raulhorgos/Dynamic-Thermal-Imaging-Camera/Photos/Test example.jpeg

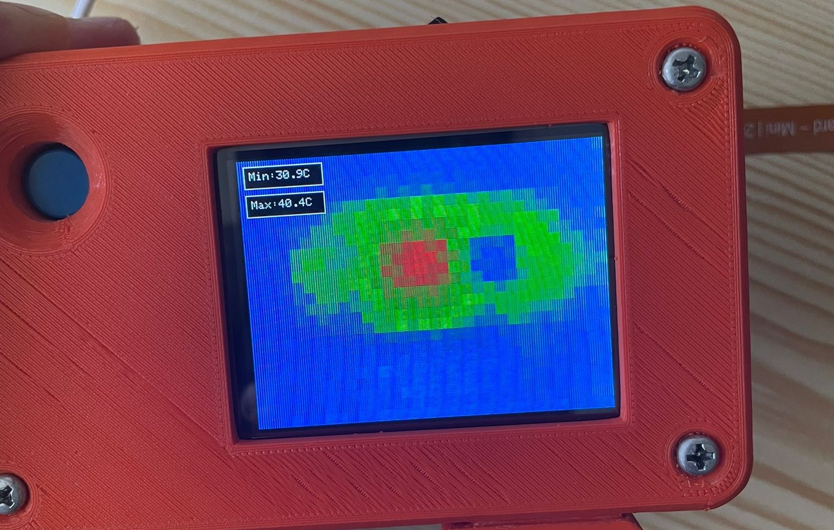
Photos/Test example.jpeg
