raulhorgos/Dynamic-Thermal-Imaging-Camera/3D render of the enclosre.png

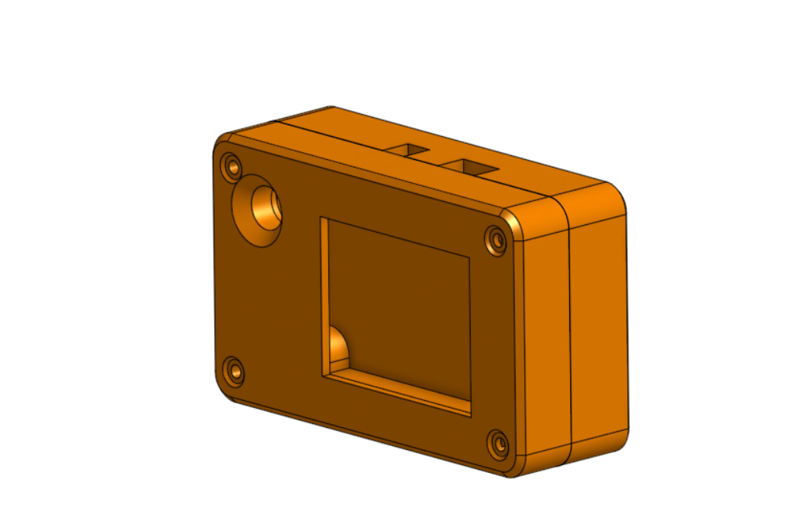
3D render of the enclosre.png
