raulhorgos/Dynamic-Thermal-Imaging-Camera/gantt.png

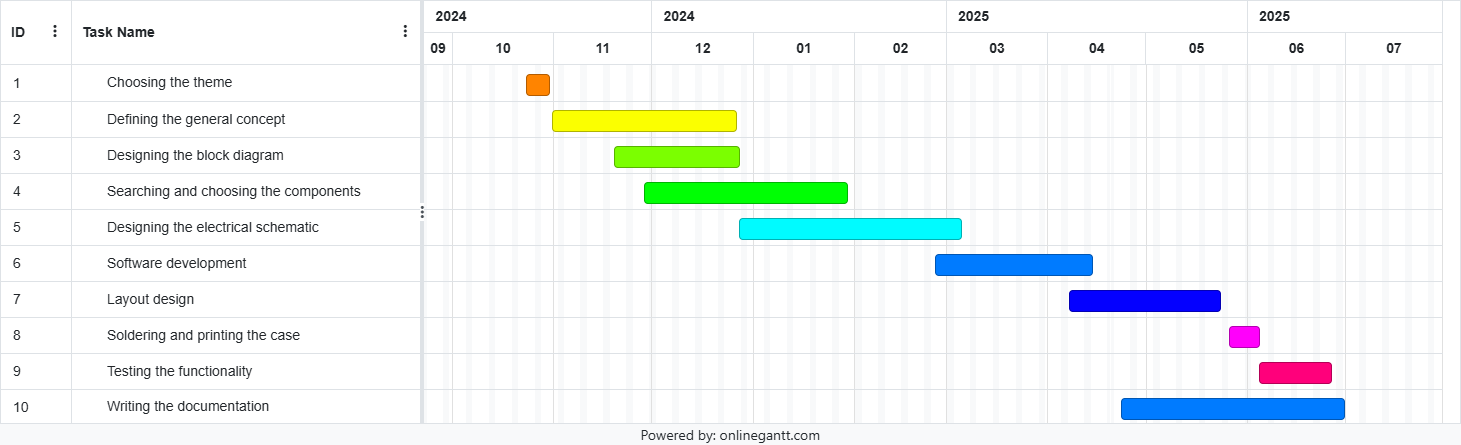
gantt.png
