raulhorgos/Dynamic-Thermal-Imaging-Camera/Photos/3D render of the eclosure.png

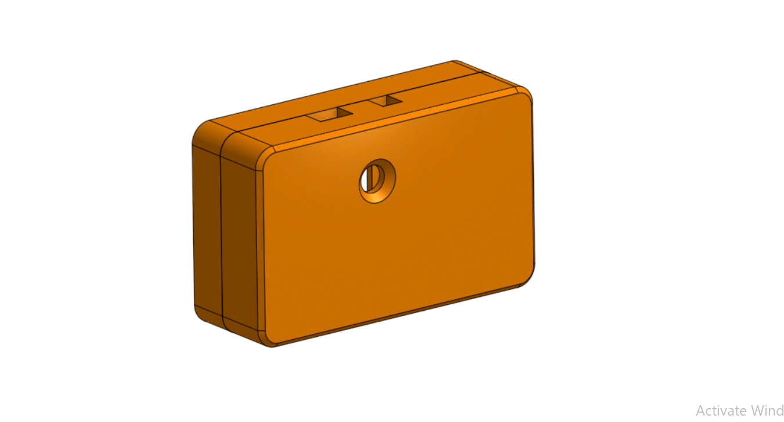
Photos/3D render of the eclosure.png
