raulhorgos/Dynamic-Thermal-Imaging-Camera/KiCad/licenta.kicad_pcb

## KiCad design KiCad/licenta.kicad_pcb (2026-10-10)

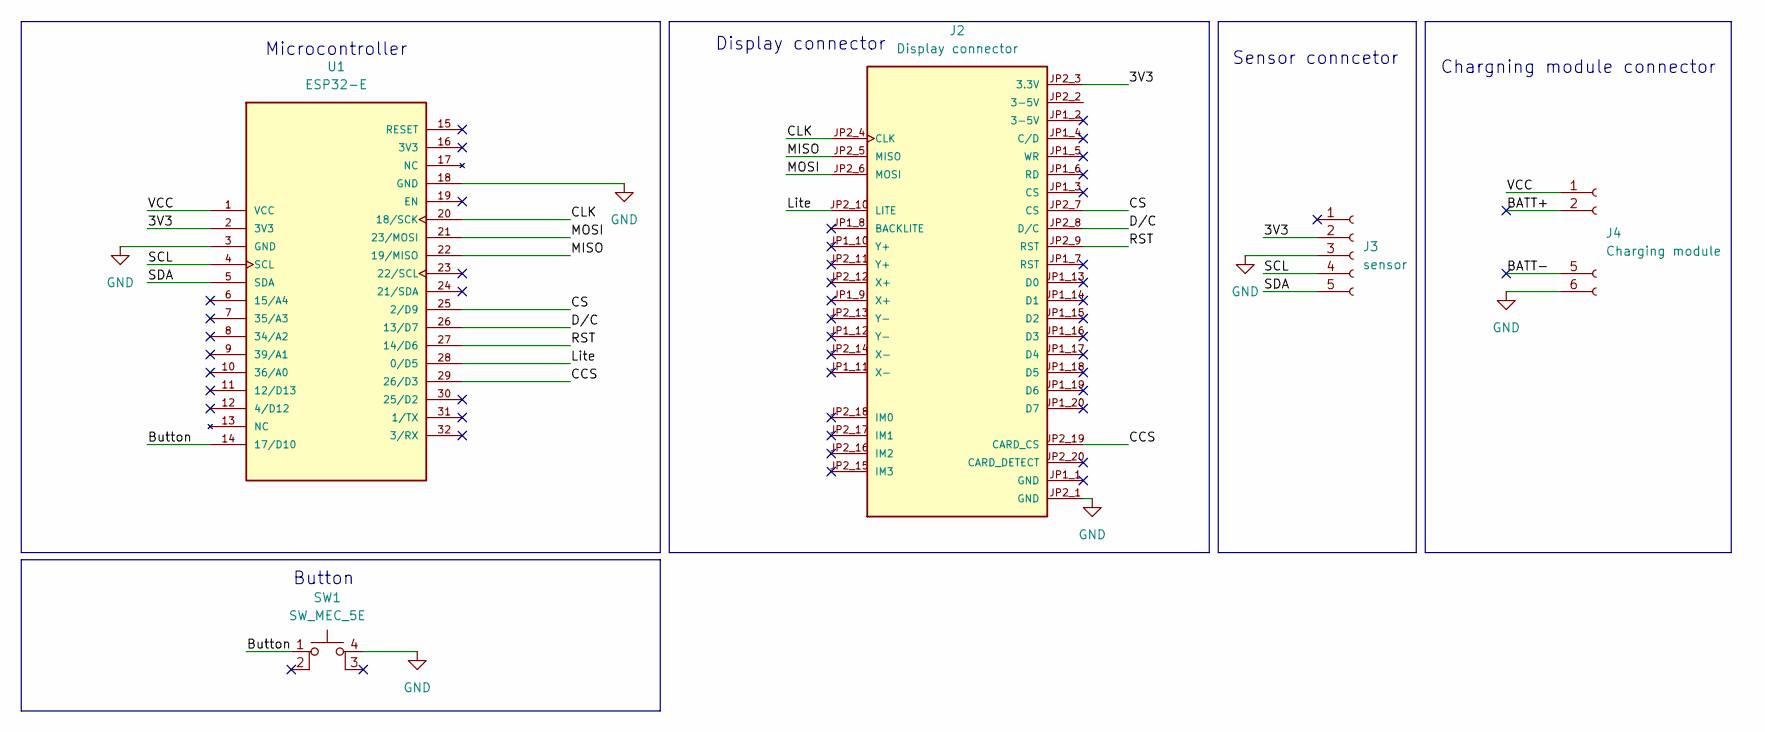
[picture p46: schematic licenta.kicad_sch]

Parts:
J2: Display connector; J2; PARTREV 2025-02-10
J3: sensor; Sensor
J4: Charging module; Charging
SW1: SW_MEC_5E; SW_PUSH-12mm
U1: ESP32-E; J1

Connections:
/3V3: J2.JP2_3 (3.3V), J3.2 (3Vo), U1.2 (3V3)
/BATT+: J4.2 (B+)
/BATT-: J4.5 (B-)
/Button: SW1.1, U1.14 (17/D10)
/CCS: J2.JP2_19 (CARD_CS), U1.29 (26/D3)
/CLK: J2.JP2_4 (CLK), U1.20 (18/SCK)
/CS: J2.JP2_7 (CS), U1.25 (2/D9)
/D/C: J2.JP2_8 (D/C), U1.26 (13/D7)
/Lite: J2.JP2_10 (LITE), U1.28 (0/D5)
/MISO: J2.JP2_5 (MISO), U1.22 (19/MISO)
/MOSI: J2.JP2_6 (MOSI), U1.21 (23/MOSI)
/RST: J2.JP2_9 (RST), U1.27 (14/D6)
/SCL: J3.4 (SCL), U1.4 (SCL)
/SDA: J3.5 (SDA), U1.5 (SDA)
/VCC: J4.1 (OUT+), U1.1 (VCC)
GND: J2.JP2_1 (GND), J3.3 (GND), J4.6 (OUT-), SW1.4 (A), U1.3 (GND), U1.18 (GND)

Notes on the sheet:
Sensor conncetor
Microcontroller
Button
Chargning module connector
Display connector

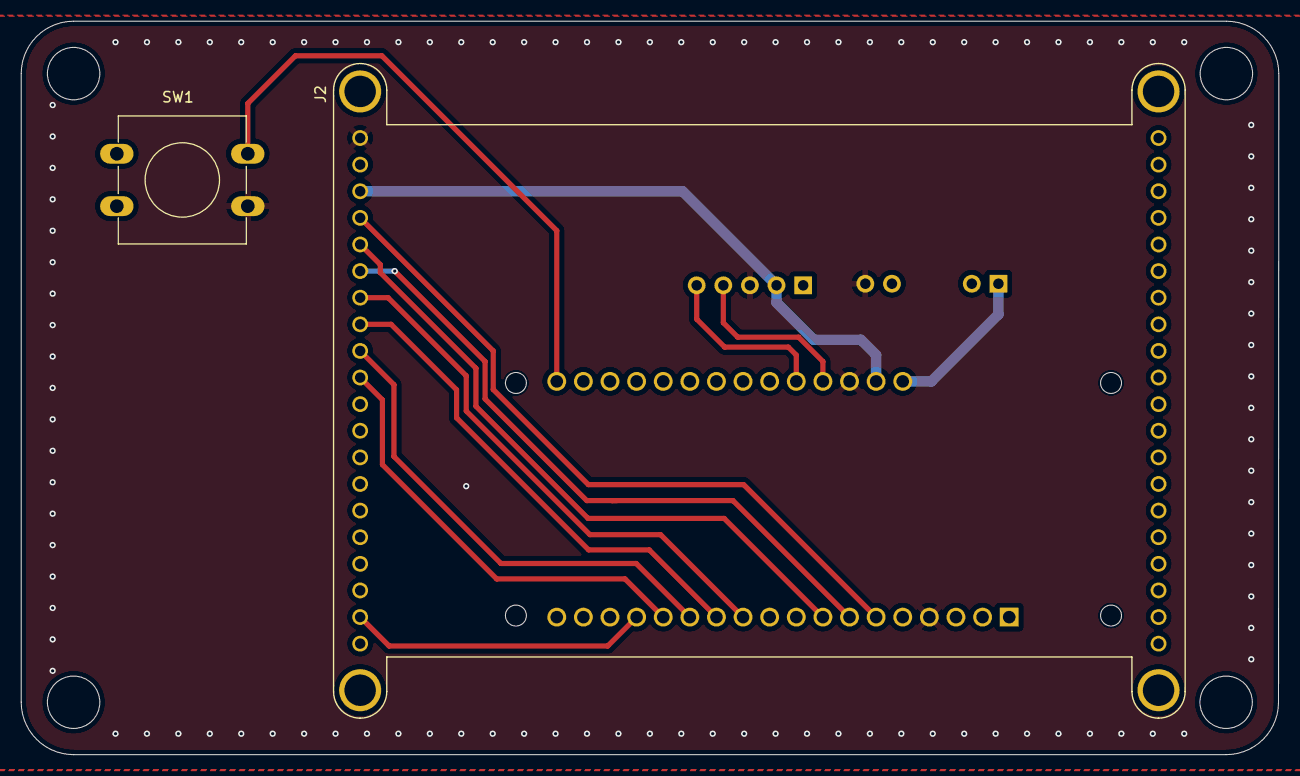
[picture p47: board licenta.kicad_pcb from above]

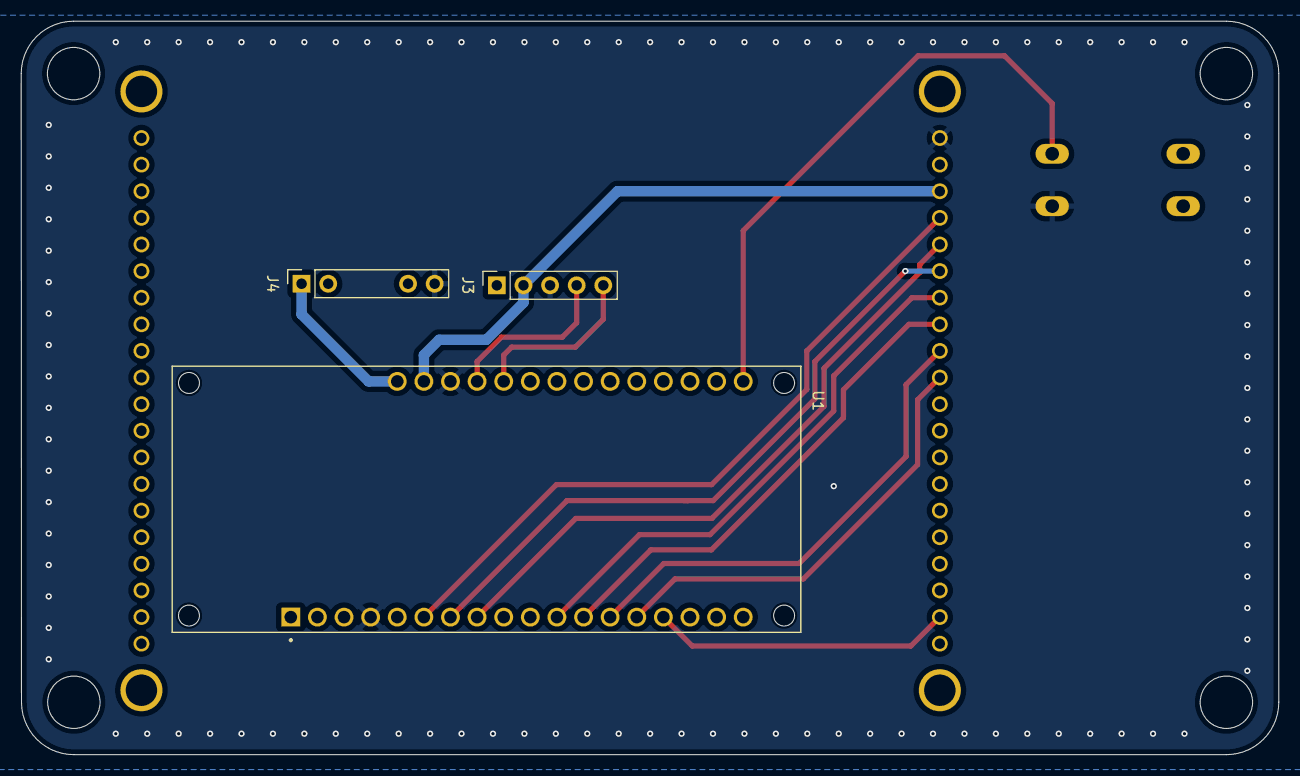
[picture p48: board licenta.kicad_pcb from below]

Board: 2 copper layers, 120.0 x 70.0 mm, 5 parts (3 on the bottom side), 14 nets.
